nrindynh/nondeviate-uwb-trilateration-bus-navigation/figures/localisation sample result.png

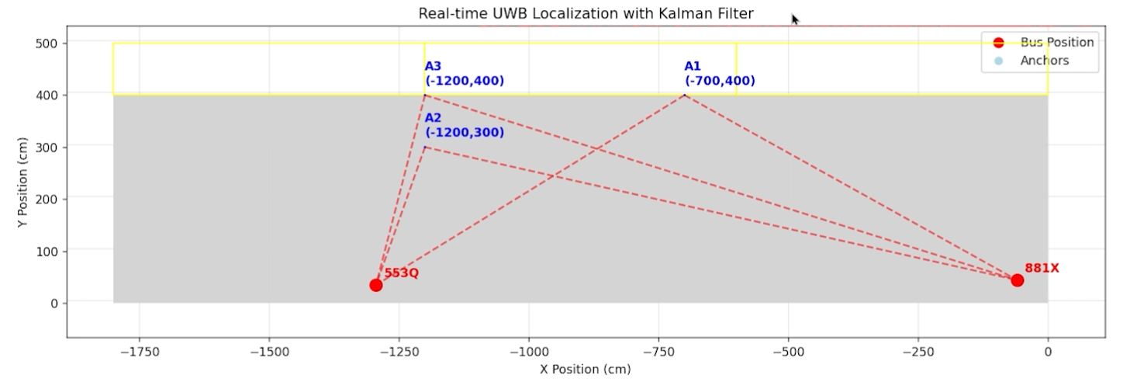
figures/localisation sample result.png
